DocHopper/Mellow-Fly-dp5/pictures/empty back panel.jpg

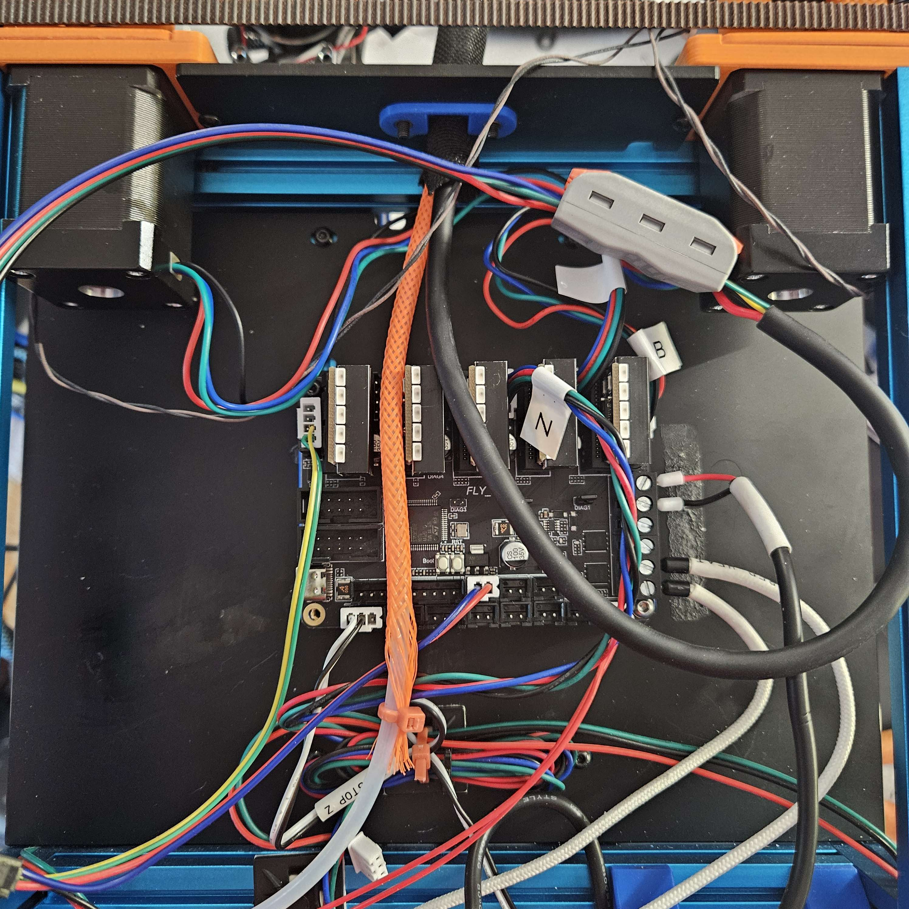
pictures/empty back panel.jpg
