DocHopper/Mellow-Fly-dp5/pictures/Port list.png

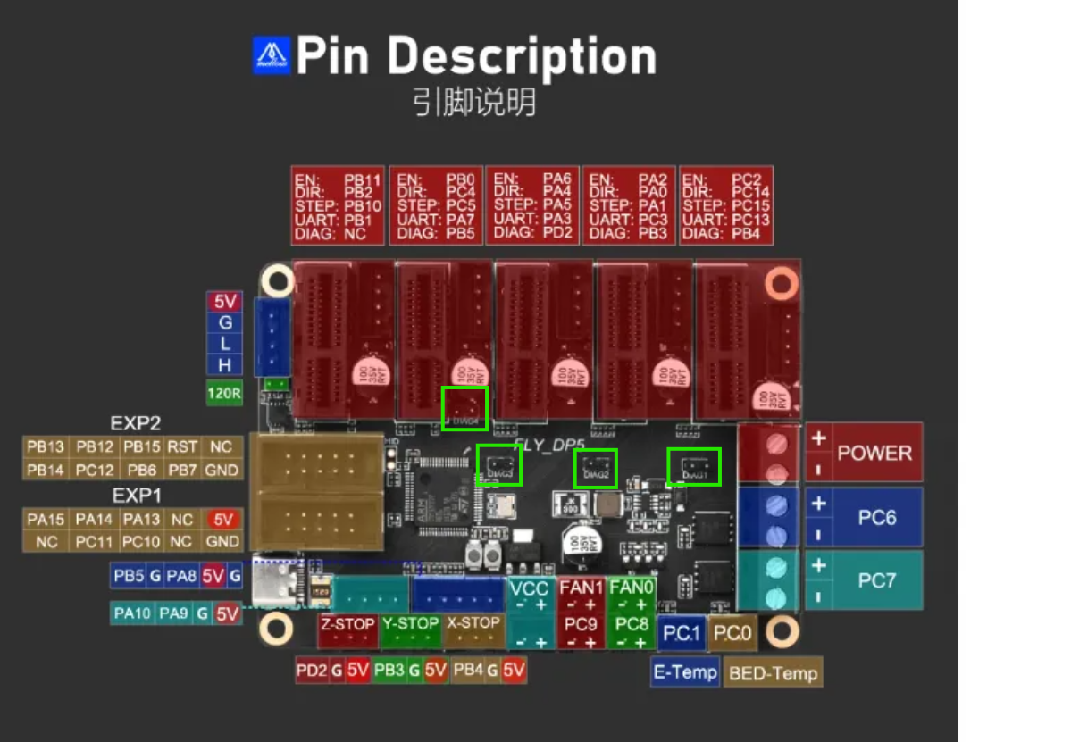
pictures/Port list.png
