DocHopper/Mellow-Fly-dp5/STLs/electronics_din_mellow_dp5_mount.stl

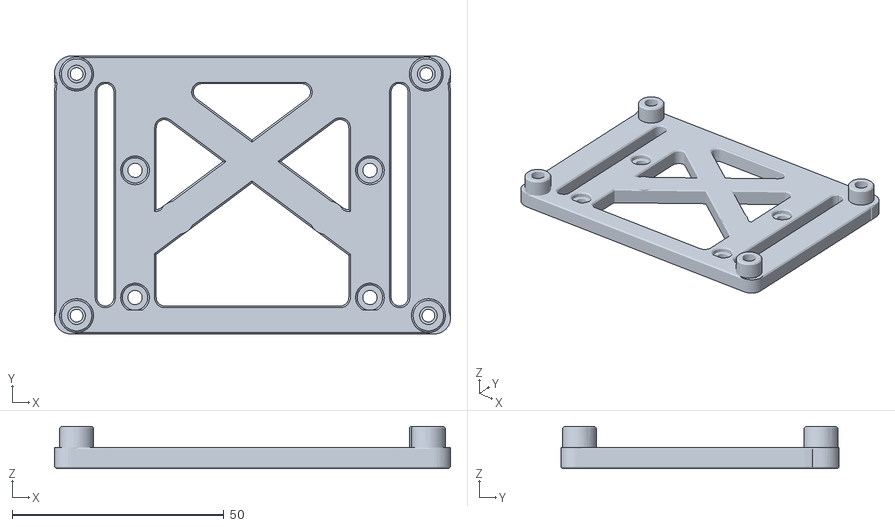
[picture p14: CAD file, 2026-10-17]
STLs/electronics_din_mellow_dp5_mount.stl
93.4 x 65.6 x 10.0
