DocHopper/Mellow-Fly-dp5/(commit log)

2026-10-17 added LED stuff
2026-10-17 post-proofing changes
    [electronics_din_mellow_dp5_mount.stl]
